thieu-b55/Slimme-meter-draadloze-P1-poort-extender-splitter/README.md

# Slimme-meter-draadloze-P1-poort-extender-splitter

Eenvoudig te bouwen draadloze  P1 poort extender / splitter

CRC16 controle van de verzonden en ontvangen data

Volledig telegram slimme meter wordt doorgestuurd

Eenvoudig te gebruiken als splitter, 1 zender kan meerdere ontvangers aansturen.

Geen electrische verbinding tussen de verschillende modules.

Voor als de afstand tot de slimme meter (te) groot is, geen extra kabels.

Verbinding P1 poort >> zender		115200 baud

Verbinding zender >> ontvanger		9600	 baud

Snelheid uitgangssignaal ontvanger		115200 baud

Met deze configuratie rijkweidte in huis +/- 10 meter, zonder CRC fouten

Uitgang ontvanger is volledig compatibel met uitgang P1 poort
